Paolasgm/Intro-to-CAD-2026/Intro-to-CAD-2026_floorplan_start.png

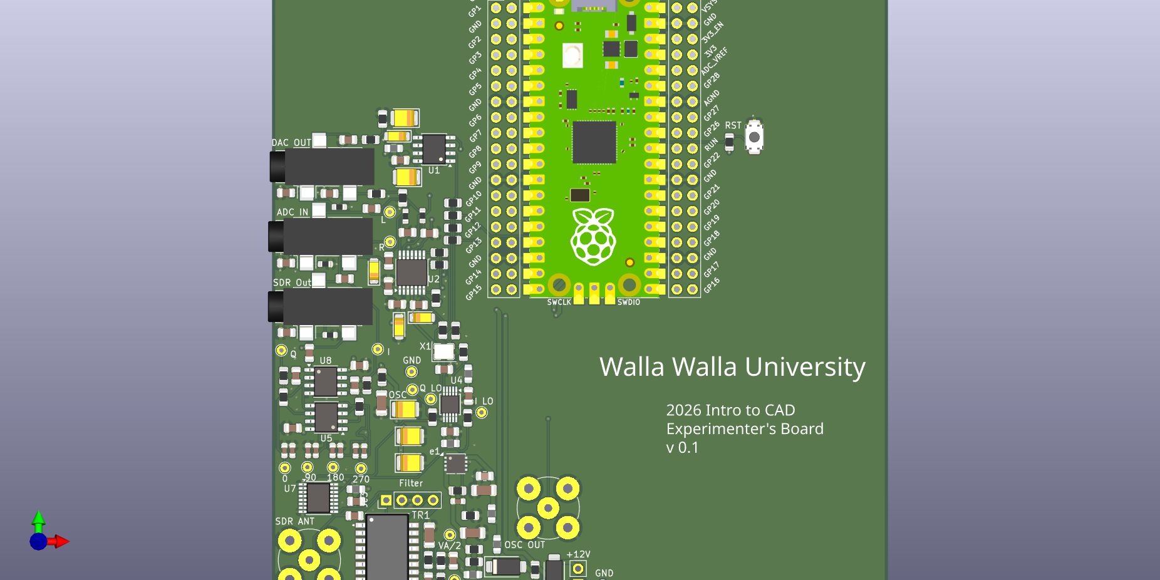
Intro-to-CAD-2026_floorplan_start.png
