Paolasgm/Intro-to-CAD-2026/audio_jack.step

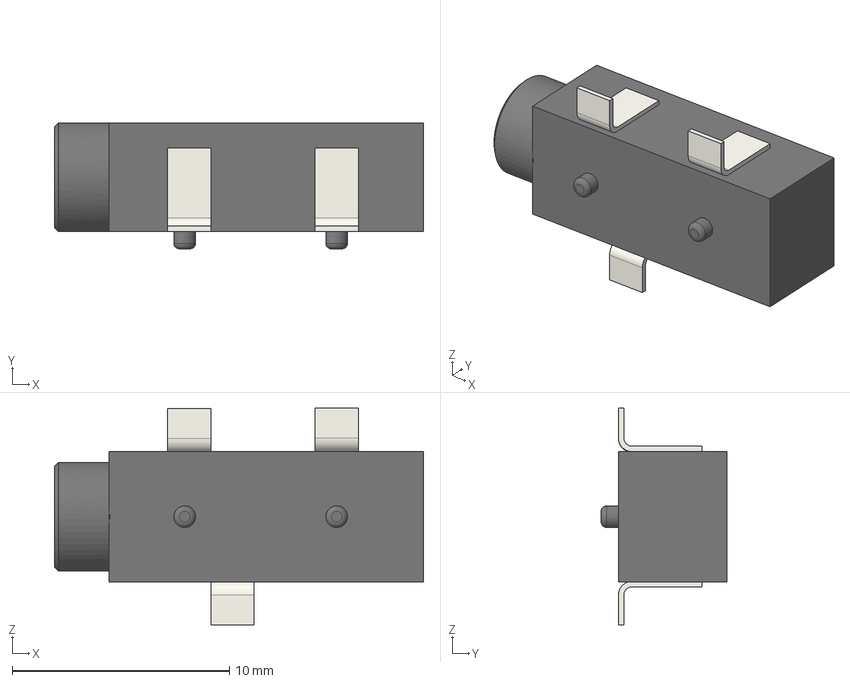
[picture p4: CAD file, 2026-02-01]
audio_jack.step
17.0 x 5.80 x 9.98 mm
sj-3524-smt-tr-pi v1 x 2
BB x 2
sj-3524-smt-tr-pi v003
sj-3524-smt-tr-pi v004 x 2
