Paolasgm/Intro-to-CAD-2026/SJ-3523-sj-3524-smt-tr-pi v005sj-3524-smt-tr-pi v003.step

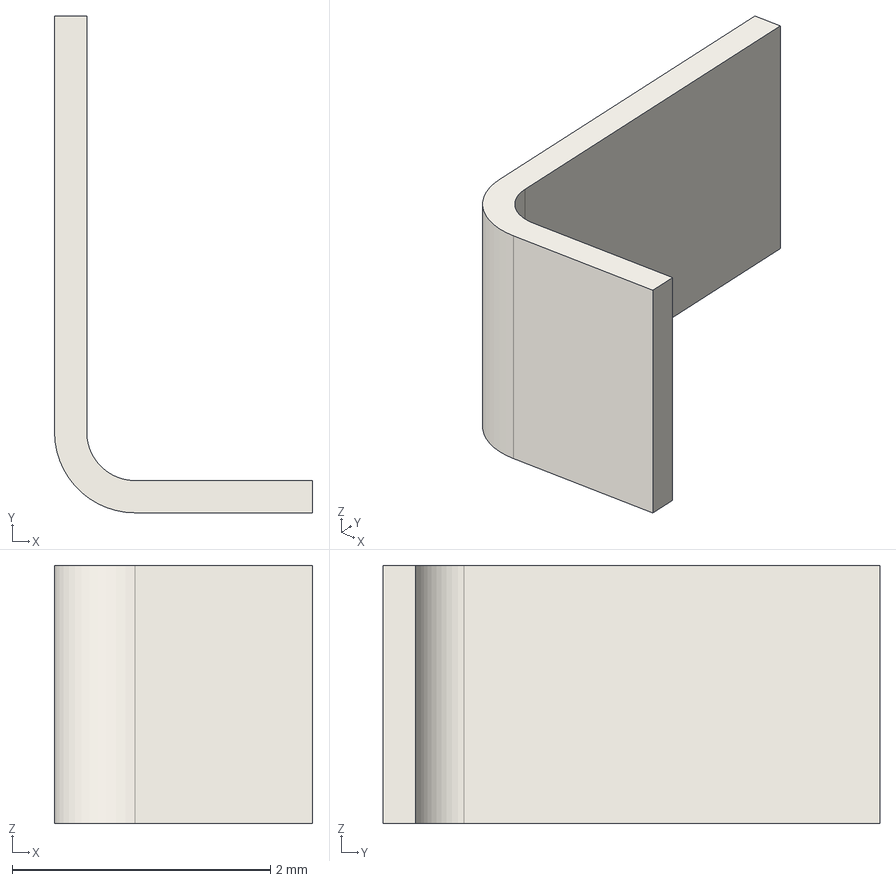
[picture p5: CAD file, 2026-02-01]
SJ-3523-sj-3524-smt-tr-pi v005sj-3524-smt-tr-pi v003.step
2.00 x 3.85 x 2.00 mm
