Paolasgm/Intro-to-CAD-2026/SJ-3523-sj-3524-smt-tr-pi v005.step

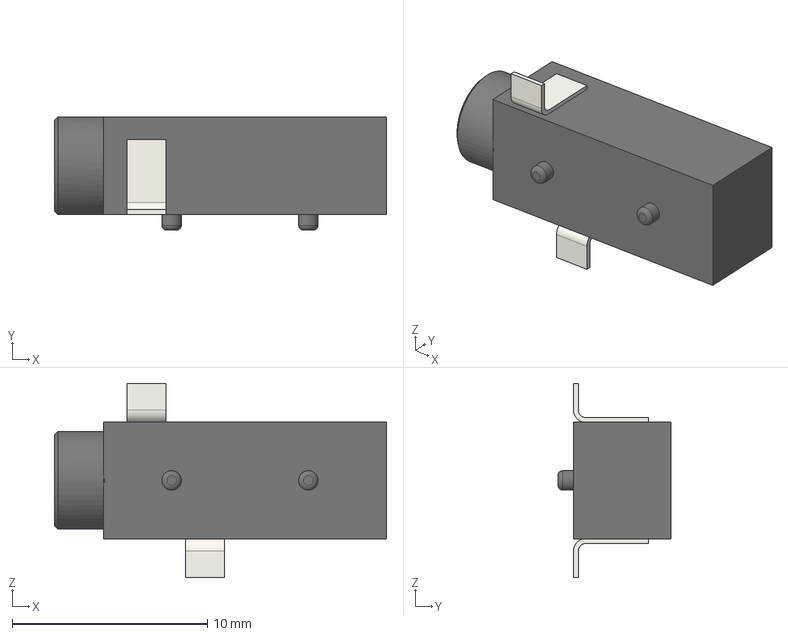
[picture p7: CAD file, 2026-02-01]
SJ-3523-sj-3524-smt-tr-pi v005.step
17.0 x 5.80 x 9.96 mm
sj-3524-smt-tr-pi v1
sj-3524-smt-tr-pi v002
sj-3524-smt-tr-pi v004
