Paolasgm/Intro-to-CAD-2026/PJ-326.step

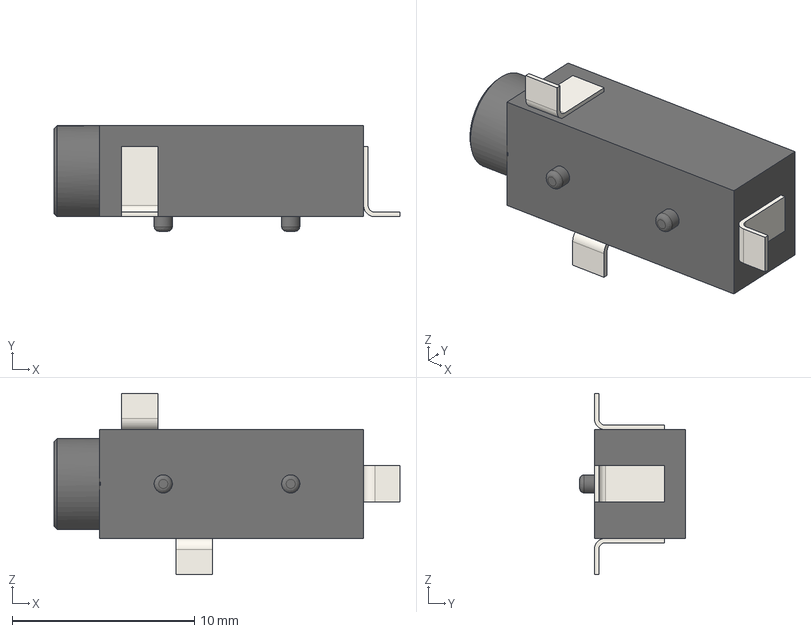
[picture p8: CAD file, 2026-02-01]
PJ-326.step
19.0 x 5.80 x 9.96 mm
