Paolasgm/Intro-to-CAD-2026/Download_STEP_150505M173300_rev1.stp

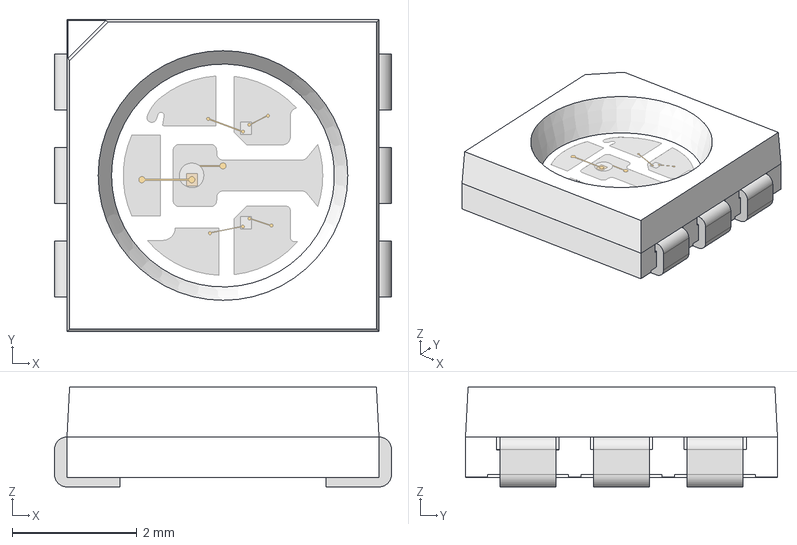
[picture p9: CAD file, 2026-02-01]
Download_STEP_150505M173300_rev1.stp
5.40 x 5.00 x 1.60 mm
cover
housing
base x 2
