Paolasgm/Intro-to-CAD-2026/Amphenol RF 122404.STEP

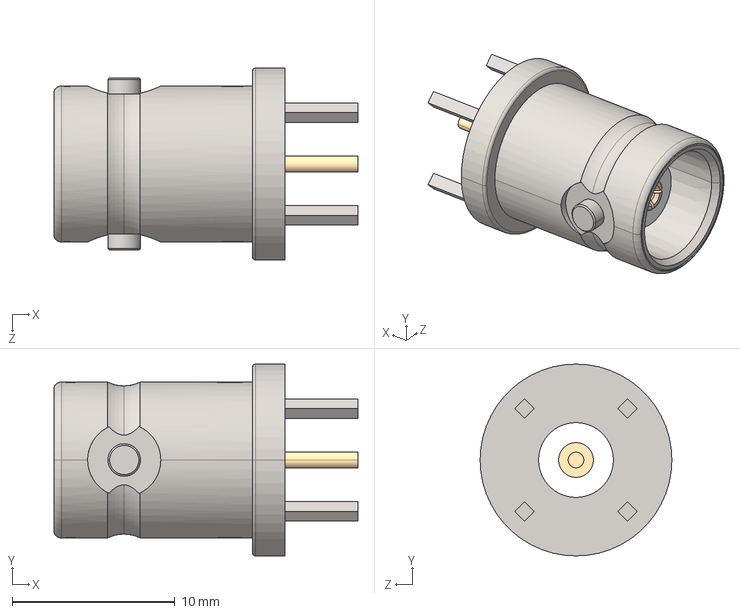
[picture p10: CAD file, 2026-02-01]
Amphenol RF 122404.STEP
18.7 x 11.8 x 11.8 mm
