Paolasgm/Intro-to-CAD-2026/Multiwatt15_V_STM.step

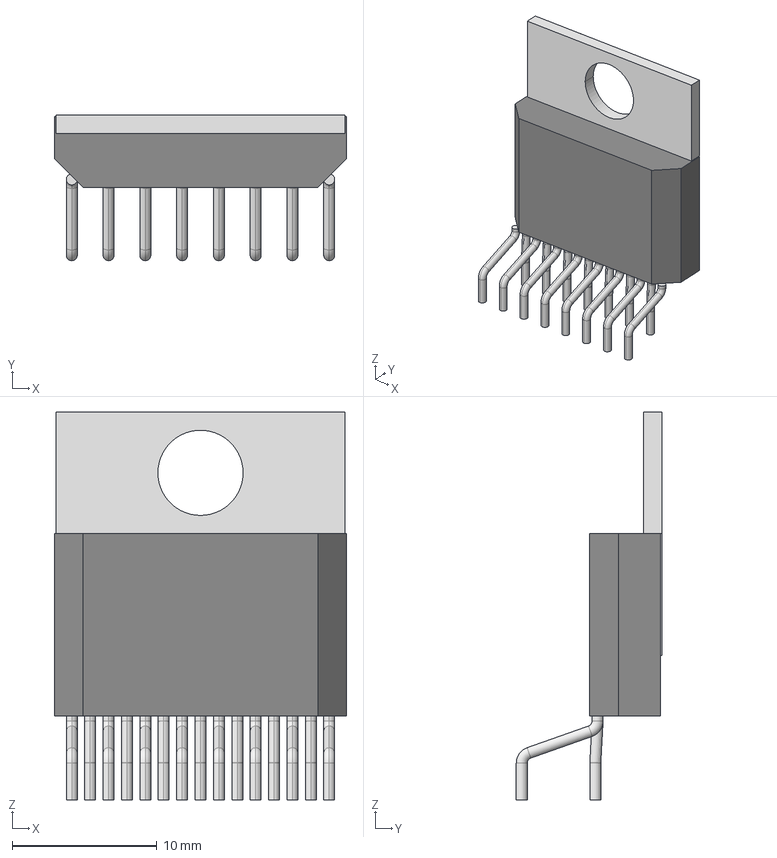
[picture p11: CAD file, 2026-02-01]
Multiwatt15_V_STM.step
20.2 x 10.1 x 26.8 mm
