Paolasgm/Intro-to-CAD-2026/H1102NLT.step

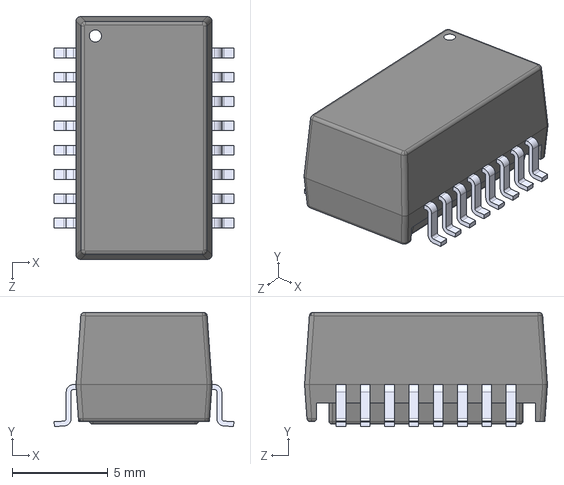
[picture p12: CAD file, 2026-01-30]
H1102NLT.step
9.40 x 5.97 x 12.7 mm
