Paolasgm/Intro-to-CAD-2026/C18594.step

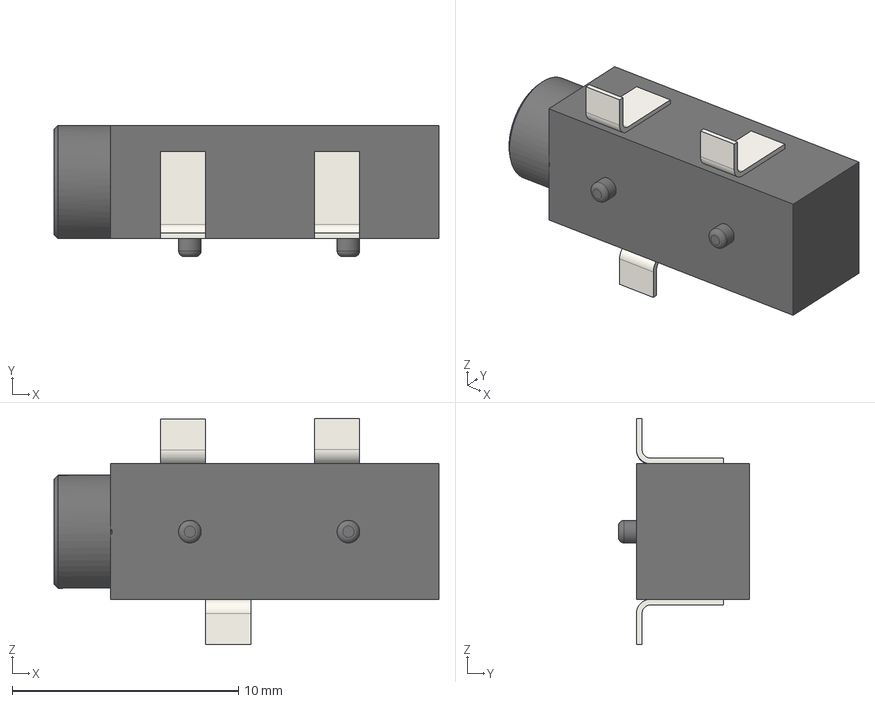
[picture p13: CAD file, 2026-02-01]
C18594.step
17.0 x 5.80 x 9.98 mm
sj-3524-smt-tr-pi v1 x 5
sj-3524-smt-tr-pi v002 x 5
sj-3524-smt-tr-pi v003 x 2
sj-3524-smt-tr-pi v004 x 2
