Paolasgm/Intro-to-CAD-2026/Intro-to-CAD-2026.kicad_pcb

## KiCad design Intro-to-CAD-2026.kicad_pcb (2026-02-07)

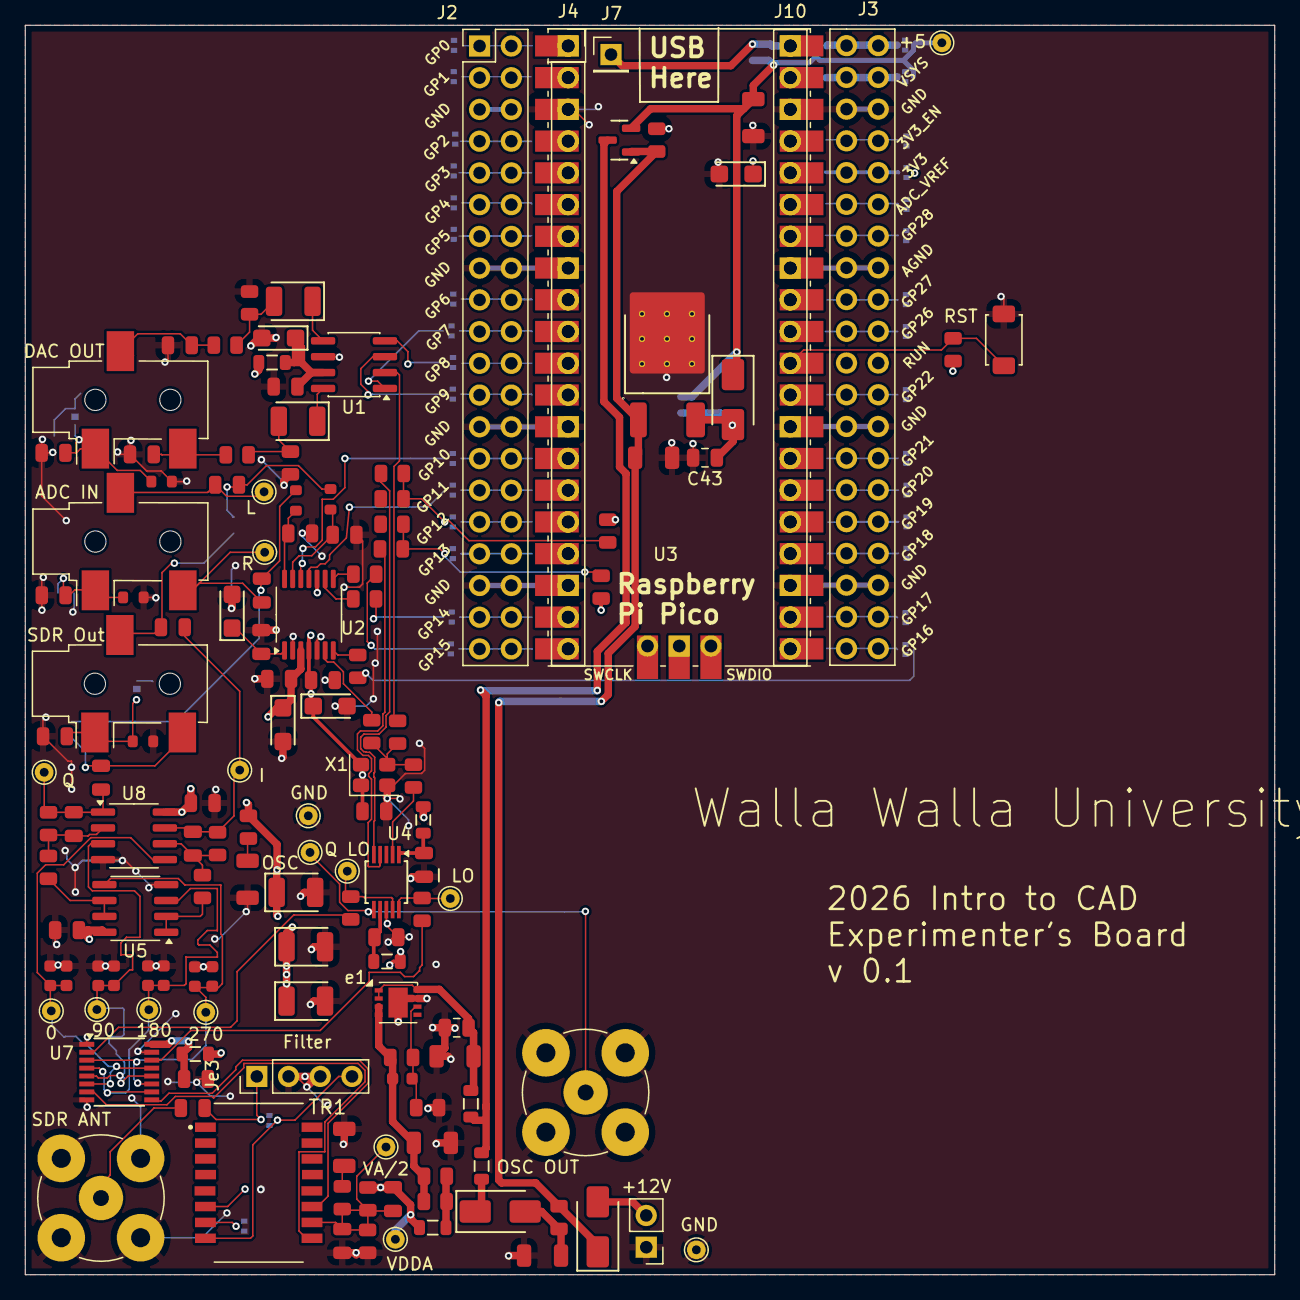
[picture p14: board Intro-to-CAD-2026.kicad_pcb from above]

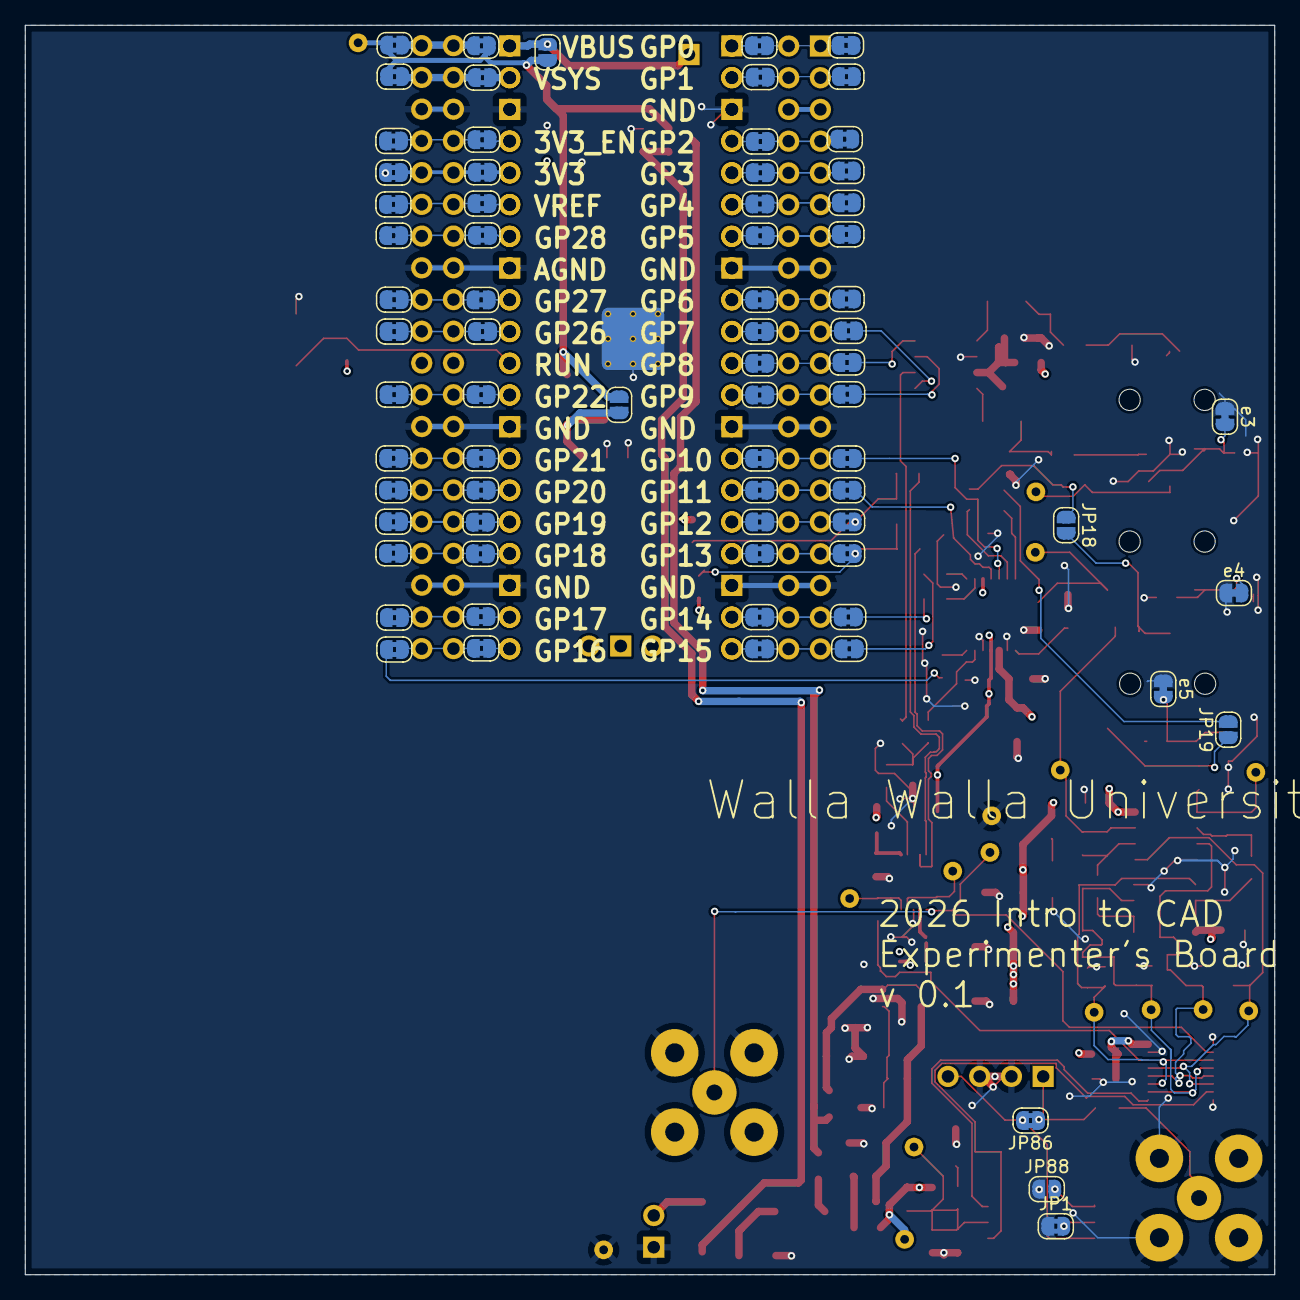
[picture p15: board Intro-to-CAD-2026.kicad_pcb from below]

Board: 4 copper layers, 100.0 x 100.0 mm, 215 parts (72 on the bottom side), 143 nets.

Parts:
C1, C10, C11, C12, C13, C15, C20, C23, C30, C31, C32, C38, C48, C50, C51, C52: 100nF; C_0805
C2, C5, C33, C34, C35, C41, C42: 10uF; C_1206
C3, C4, C21, C29: 1uF; C_0805
C6, C7, C49, C53: 2.2nF; C_0805
C8, C9, C39, C44, C45: 10uF; C_CASE-A-3216-18(mm)
C14, C16, C19, C22, C24, C25, C26, C27: 330pF; C_0603
C17, C36, C37, C46, C47: 100uF; C_CASE-B-3528-21(mm)
C18, C28: 100pF; C_0805
C40: 4.7pF; C_0603
C43, C55: 0.1u; C_0805_2012Metric
D1, D2, D3: SS14; D_SMA
FB1, FB2, FB3, FB4, FB5, FB6, FB7: FB_0805
J1: ADC IN; Jack_3.5mm_CUI_SJ-3523-SMT_Horizontal
J2: Conn_02x20_Counter_Clockwise; PinSocket_2x20_P2.54mm_Vertical_pins1-20
J3: Conn_02x20_Counter_Clockwise; PinSocket_2x20_P2.54mm_Vertical_Counterclockwise_pins21-40
J4: Conn_01x20_Socket; PinSocket_1x20_P2.54mm_Vertical
J5: +12V; PinHeader_1x02_P2.54mm_Vertical
J7: Conn_01x01_Pin; PinHeader_1x01_P2.54mm_Vertical
J8: OSC OUT; BNC_TEConnectivity_1478204_Vertical
J9: DAC OUT; Jack_3.5mm_CUI_SJ-3523-SMT_Horizontal
J10: Conn_01x20_Socket; PinSocket_1x20_P2.54mm_Vertical-pins21-40
J11: SDR ANT; BNC_TEConnectivity_1478204_Vertical
J12: SDR Out; Jack_3.5mm_CUI_SJ-3523-SMT_Horizontal
JP1, JP20, JP21, JP22, JP23, JP24, JP25, JP26, JP27, JP28, JP29, JP30, JP31, JP32, JP33, JP34, JP35, JP36, JP37, JP38, JP39, JP40, JP41, JP42, JP43, JP44, JP45, JP46, JP47, JP48, JP49, JP51, JP52, JP53, JP54, JP55, JP56, JP57, JP58, JP59, JP60, JP61, JP62, JP63, JP64, JP65, JP66, JP67, JP68, JP70, JP71, JP72, JP73, JP74, JP75, JP76, JP77, JP78, JP79, JP80, JP81, JP82, JP83, JP86: Jumper_2_Bridged; SolderJumper-2_P1.3mm_Bridged2Bar_RoundedPad1.0x1.5mm
JP2: SolderJumper-2_P1.3mm_Open_RoundedPad1.0x1.5mm
JP18, JP19, JP88: GND_LP_SND; SolderJumper-2_P1.3mm_Open_RoundedPad1.0x1.5mm
JP50: USB Only; SolderJumper-2_P1.3mm_Open_RoundedPad1.0x1.5mm
Je3: Filter; PinHeader_1x04_P2.54mm_Vertical
Q1: AO3401A; Q_SOT-23
R1, R4, R12, R13, R31, R32: 10kΩ; R_0805
R2, R3: 430Ω; R_0603
R5: 33kΩ; R_0805
R6: 12kΩ; R_0805
R7, R10, R11, R20, R21: 1Ω; R_0805
R8, R9: 47Ω; R_0805
R14, R19, R30: 10Ω; R_0603
R15, R23: 4.7kΩ; R_0805
R16, R17, R18, R34, R35, R36, R37, R38: 33Ω; R_0805
R22, R33: 560Ω; R_0805
R24, R25, R26, R27: 100Ω; R_0805
R28: 100kΩ; R_0805
R29: 20kΩ; R_0805
S1: RST; SW_TS-1088-AR02016
TP1: L; TestPoint_THTPad_D1.5mm_Drill0.7mm
TP2: R; TestPoint_THTPad_D1.5mm_Drill0.7mm
TP3: I LO; TestPoint_THTPad_D1.5mm_Drill0.7mm
TP4: Q LO; TestPoint_THTPad_D1.5mm_Drill0.7mm
TP5: OSC; TestPoint_THTPad_D1.5mm_Drill0.7mm
TP6: 180; TestPoint_THTPad_D1.5mm_Drill0.7mm
TP7: 270; TestPoint_THTPad_D1.5mm_Drill0.7mm
TP10, TP12: GND; TestPoint_THTPad_D1.5mm_Drill0.7mm
TP11: VA/2; TestPoint_THTPad_D1.5mm_Drill0.7mm
TP14: 0; TestPoint_THTPad_D1.5mm_Drill0.7mm
TP16: 90; TestPoint_THTPad_D1.5mm_Drill0.7mm
TP17: I; TestPoint_THTPad_D1.5mm_Drill0.7mm
TP18: Q; TestPoint_THTPad_D1.5mm_Drill0.7mm
TP25: +5; TestPoint_THTPad_D1.5mm_Drill0.7mm
TP26: VDDA; TestPoint_THTPad_D1.5mm_Drill0.7mm
TR1: H1102NLT; XFMR_H1102NLT
U1: CJC4334H; SOIC-8_3.9x4.9mm_P1.27mm
U2: PCM1808PWR; TSSOP-14_4.4x5mm_P0.65mm
U3: Pico; RPi_Pico_SMD_TH
U4: MS5351M; MSOP-10_3x3mm_P0.5mm
U5, U8: OPA1612AxD; SOIC-8_3.9x4.9mm_P1.27mm
U6: L78M05ABDT-TR; TO-252-2_L6.5-W6.1-P4.58-LS10.0-TL
U7: SN74CBT3253; SSOP-16_3.9x4.9mm_P0.635mm
X1: YC24.576MUBCE2O; Oscillator_SMD_Abracon_ASE-4Pin_3.2x2.5mm
e1: SGM2205-ADJXTDB8G/TR; DFN-8-1EP_3x3mm_P0.65mm_EP1.55x2.4mm
e3, e4, e5: Groundloop_Insurance; SolderJumper-2_P1.3mm_Bridged_RoundedPad1.0x1.5mm

Connections:
+3.3V: C8.1, C10.2, C39.1, C48.1, FB1.1, FB4.2, FB7.2, J2.3 (Pin_38), J3.30 (Pin_11), JP23.1 (A), R15.1, R23.1, R29.1, U2.4 (VDD), U2.10 (MD0), X1.1 (EN), X1.4 (Vdd)
+4.7V: C2.1, D3.1, JP2.2 (B), JP20.1 (A), JP21.1 (A), JP35.2 (B), JP50.2 (B), Q1.2 (S), TP25.1
/BCK: JP83.2 (B), R17.2
/CMOS Oscillator/LO_CLK: R36.1, U4.2 (XA)
/CMOS Oscillator/SCKI: R35.2, U2.6 (SCKI)
/CMOS Oscillator/SCLK: R34.1, U1.2 (SCLK)
/DATA: JP82.2 (B), R18.2
/FMT: JP78.2 (B), U2.12 (FMT)
/I: C29.2, J12.R, JP18.2 (B)
/I_CLK: R37.1, U7.14 (S0)
/LRCK: JP77.2 (B), U1.3 (LRCK)
/MCLK: JP76.2 (B), U1.4 (MCLK)
/MD1: JP79.2 (B), U2.11 (MD1)
/OSC_SCL: R25.1, U4.4 (SCL)
/OSC_SDA: R24.1, U4.5 (SDA)
/Q: C21.1, J12.T, JP19.1 (A)
/Q_CLK: R38.1, U7.2 (S1)
/Raspberry_Pi_Pico/GPIO12: JP80.2 (B), R15.2, R24.2, R27.2
/Raspberry_Pi_Pico/GPIO13: JP81.2 (B), R23.2, R25.2, R26.2
/Raspberry_Pi_Pico/RST: J10.30 (Pin_11), R29.2, S1.1 (A), U3.30 (RUN)
/SDIN: JP75.2 (B), U1.1 (SDIN)
/Si5351a/CLK2: J8.1 (In), TP5.1, U4.6 (CLK2)
/WS: JP34.1 (A), R16.2
GND: C2.2, C5.2, C6.2, C7.2, C8.2, C9.2, C10.1, C11.1, C12.2, C13.1, C14.2, C15.1, C16.2, C17.2, C19.2, C20.1, C22.2, C23.1, C24.2, C25.2, C26.2, C27.2, C30.1, C31.1, C33.2, C34.2, C35.2, C36.2, C37.2, C38.1, C39.2, C41.2, C42.2, C43.2, C44.2, C45.2, C48.2, C49.2, C50.1, C51.1, C52.1, C53.2, C55.2, J2.8 (Pin_33), J2.13, J2.18, J3.23 (Pin_18), J3.28, J3.33 (Pin_8), J3.38, J4.3, J4.8, J4.13, J4.18, J5.1, J8.2 (Ext), J10.23 (Pin_18), J10.28 (Pin_13), J10.33 (Pin_8), J10.38 (Pin_3), J11.2 (Ext), JP1.1 (A), JP88.1 (A), Je3.2, Je3.3, R4.1, R6.2, R14.2, R19.2, R28.2, R30.2, R31.2, R32.2, S1.2 (B), TP10.1, TP12.1, U1.6 (GND), U2.2 (AGND), U2.5 (DGND), U3.3 (GND), U3.8 (GND), U3.13 (GND), U3.18 (GND), U3.23 (GND), U3.28 (GND), U3.33 (AGND), U3.38 (GND), U4.8 (GND), U5.4 (V-), U6.4 (GND), U7.1 (1~OE), U7.8 (GND), U7.15 (2~OE), U8.4 (V-), X1.2 (GND), e1.7 (GND), e1.9 (PAD), e3.1 (A), e4.1 (A), e5.1 (A)
unnamed: C3.2, J1.R, TP1.1
unnamed: C4.2, J1.T, TP2.1
unnamed: C18.2, C29.1, R12.2, TP17.1, U8.7
unnamed: C21.2, C28.2, R13.2, TP18.1, U8.1
unnamed: C33.1, R11.2
unnamed: C34.1, R10.2
unnamed: C35.1, C40.1, R5.2, R7.1, R20.1, e1.3 (VOUT), e1.4 (VOUT)
unnamed: C42.1, D1.2, R21.1
unnamed: C46.2, R22.1, R32.1
unnamed: C47.2, R31.1, R33.1
unnamed: C49.1, J9.R, R22.2
unnamed: C53.1, J9.T, R33.2
unnamed: D1.1, FB2.2
unnamed: FB5.1, R7.2, R20.2
unnamed: J2.1, JP51.2 (B), JP67.1 (A)
unnamed: J2.2, JP52.2 (B), JP68.1 (A)
unnamed: J2.10, JP58.2 (B), JP75.1 (A)
unnamed: J2.11, JP59.2 (B), JP76.1 (A)
unnamed: J2.12, JP60.2 (B), JP77.1 (A)
unnamed: J2.14, JP61.2 (B), JP78.1 (A)
unnamed: J2.15, JP62.2 (B), JP79.1 (A)
unnamed: J2.16, JP63.2 (B), JP80.1 (A)
unnamed: J2.17, JP64.2 (B), JP81.1 (A)
unnamed: J2.19, JP65.2 (B), JP82.1 (A)
unnamed: J2.20, JP66.2 (B), JP83.1 (A)
unnamed: J2.9, JP57.2 (B), JP74.1 (A)
unnamed: J2.7, JP56.2 (B), JP73.1 (A)
unnamed: J2.6, JP55.2 (B), JP72.1 (A)
unnamed: J2.5, JP54.2 (B), JP71.1 (A)
unnamed: J2.4, JP53.2 (B), JP70.1 (A)
unnamed: J3.40 (Pin_1), JP20.2 (B), JP35.1 (A)
unnamed: J3.39 (Pin_2), JP21.2 (B), JP36.1 (A)
unnamed: J3.31 (Pin_10), JP27.2 (B), JP42.1 (A)
unnamed: J3.29 (Pin_12), JP28.2 (B), JP43.1 (A)
unnamed: J3.27 (Pin_14), JP29.2 (B), JP44.1 (A)
unnamed: J3.26 (Pin_15), JP30.2 (B), JP45.1 (A)
unnamed: J3.25 (Pin_16), JP31.2 (B), JP46.1 (A)
unnamed: J3.24 (Pin_17), JP32.2 (B), JP47.1 (A)
unnamed: J3.22 (Pin_19), JP33.2 (B), JP48.1 (A)
unnamed: J3.21 (Pin_20), JP34.2 (B), JP49.1 (A)
unnamed: J3.32 (Pin_9), JP26.2 (B), JP41.1 (A)
unnamed: J3.34 (Pin_7), JP25.2 (B), JP40.1 (A)
unnamed: J3.35 (Pin_6), JP24.2 (B), JP39.1 (A)
unnamed: J3.36 (Pin_5), JP23.2 (B), JP38.1 (A)
unnamed: J3.37 (Pin_4), JP22.2 (B), JP37.1 (A)
unnamed: J4.1, JP51.1 (A), U3.1 (GPIO0)
unnamed: J4.2, JP52.1 (A), U3.2 (GPIO1)
unnamed: J4.4, JP53.1 (A), U3.4 (GPIO2)
unnamed: J4.5, JP54.1 (A), U3.5 (GPIO3)
unnamed: J4.6, JP55.1 (A), U3.6 (GPIO4)
unnamed: J4.7, JP56.1 (A), U3.7 (GPIO5)
unnamed: J4.9, JP57.1 (A), U3.9 (GPIO6)
unnamed: J4.10, JP58.1 (A), U3.10 (GPIO7)
unnamed: J4.11, JP59.1 (A), U3.11 (GPIO8)
unnamed: J4.12, JP60.1 (A), U3.12 (GPIO9)
unnamed: J4.14, JP61.1 (A), U3.14 (GPIO10)
unnamed: J4.15, JP62.1 (A), U3.15 (GPIO11)
unnamed: J4.16, JP63.1 (A), U3.16 (GPIO12)
unnamed: J4.17, JP64.1 (A), U3.17 (GPIO13)
unnamed: J4.19, JP65.1 (A), U3.19 (GPIO14)
unnamed: J4.20, JP66.1 (A), U3.20 (GPIO15)
unnamed: D2.2, J5.2
unnamed: J7.1, J10.40 (Pin_1), JP50.1 (A), U3.40 (VBUS)
unnamed: J10.39 (Pin_2), JP36.2 (B), U3.39 (VSYS)
unnamed: J10.37 (Pin_4), JP37.2 (B), U3.37 (3V3_EN)
unnamed: J10.36 (Pin_5), JP38.2 (B), U3.36 (3V3)
unnamed: J10.35 (Pin_6), JP39.2 (B), U3.35 (ADC_VREF)
unnamed: J10.34 (Pin_7), JP40.2 (B), U3.34 (GPIO28_ADC2)
unnamed: J10.32 (Pin_9), JP41.2 (B), U3.32 (GPIO27_ADC1)
unnamed: J10.31 (Pin_10), JP42.2 (B), U3.31 (GPIO26_ADC0)
unnamed: J10.29 (Pin_12), JP43.2 (B), U3.29 (GPIO22)
unnamed: J10.27 (Pin_14), JP44.2 (B), U3.27 (GPIO21)
unnamed: J10.26 (Pin_15), JP45.2 (B), U3.26 (GPIO20)
unnamed: J10.25 (Pin_16), JP46.2 (B), U3.25 (GPIO19)
unnamed: J10.24 (Pin_17), JP47.2 (B), U3.24 (GPIO18)
unnamed: J10.22 (Pin_19), JP48.2 (B), U3.22 (GPIO17)
unnamed: J10.21 (Pin_20), JP49.2 (B), U3.21 (GPIO16)
unnamed: C1.1, J11.1 (In)
unnamed: JP1.2 (B), TR1.7 (C_RD)
unnamed: C43.1, D3.2, JP2.1 (A), U6.3 (VOUT)
unnamed: C3.1, JP18.1 (A), R2.1
unnamed: C4.1, JP19.2 (B), R3.1
unnamed: C1.2, JP86.1 (A), Je3.1
unnamed: JP86.2 (B), Je3.4, TR1.8 (RD-)
unnamed: JP88.2 (B), TR1.6 (RD+)
unnamed: FB2.1, FB6.1, Q1.3 (D)
unnamed: C41.1, D2.1, Q1.1 (G), R21.2, R28.1, U6.1 (VIN)
unnamed: C20.2, C32.2, R1.1, R4.2, R10.1, TP11.1, TR1.10 (C_RX)
unnamed: TR1.11 (RX+), U7.9 (2A)
unnamed: TR1.9 (RX-), U7.7 (1A)
unnamed: C47.1, U1.8 (AOUTL)
unnamed: C46.1, U1.5 (AOUTR)
unnamed: C12.1, C45.1, FB7.1, U1.7 (VDD)
unnamed: R17.1, U2.8 (BCK)
unnamed: R18.1, U2.9 (DOUT)
unnamed: R16.1, U2.7 (LRCK)
unnamed: C6.1, R2.2, U2.13 (VINL)
unnamed: C7.1, R3.2, U2.14 (VINR)
unnamed: C11.2, C44.1, U2.1 (VREF)
unnamed: R37.2, TP3.1, U4.10 (CLK0)
unnamed: R38.2, TP4.1, U4.9 (CLK1)
unnamed: C15.2, FB4.1, U4.1 (VDD)
unnamed: C38.2, FB1.2, U4.7 (VDDO)
unnamed: C22.1, C26.1, TP6.1, U5.3 (+), U7.4 (1B3), U7.10 (2B1)
unnamed: R8.1, U5.1, U5.2 (-)
unnamed: C24.1, C27.1, TP7.1, U5.5 (+), U7.3 (1B4), U7.11 (2B2)
unnamed: R9.1, U5.6 (-), U5.7
unnamed: C14.1, C16.1, TP14.1, U7.6 (1B1), U7.13 (2B4), U8.5 (+)
unnamed: C19.1, C25.1, TP16.1, U7.5 (1B2), U7.12 (2B3), U8.3 (+)
unnamed: C23.2, FB3.1, U7.16 (VCC)
unnamed: C28.1, R9.2, R13.1, U8.2 (-)
unnamed: C18.1, R8.2, R12.1, U8.6 (-)
unnamed: R34.2, R35.1, R36.2, X1.3 (OUT)
unnamed: C5.1, C55.1, FB6.2, e1.1 (VIN), e1.2 (VIN), e1.8 (EN)
unnamed: C40.2, R5.1, R6.1, e1.6 (SENSE/ADJ)
unnamed: C50.2, J9.S, R19.1, e3.2 (B)
unnamed: C51.2, J1.S, R14.1, e4.2 (B)
unnamed: C52.2, J12.S, R30.1, e5.2 (B)
VDDA: C9.1, C13.2, C17.1, C30.2, C31.2, C32.1, C36.1, C37.1, FB3.2, FB5.2, R1.2, R11.1, TP26.1, U2.3 (VCC), U5.8 (V+), U8.8 (V+)
