Paolasgm/Intro-to-CAD-2026/(commit log)

2026-01-30 Added a Module Template
    [Intro-to-CAD-2026.kicad_sch, Module_Template.kicad_pcb, Module_Template.kicad_sch, raspberry_pi_pico.kicad_sch]
2026-01-30 Making module instructions...
    [PCM1808_Sound_In.kicad_sch]
2026-01-30 Moved my development to Frohne
    [Frohne.kicad_pcb, Frohne.kicad_sch, Module_Template.kicad_sch, VDDA.kicad_sch, pcm1808.kicad_sch, qsd-sdr.kicad_sch, raspberry_pi_pico.kicad_sch, si5351a.kicad_sch]
2026-01-31 Fixed the rest of the schematic errors
    [Module_Template.kicad_sch]
2026-02-01 Fixed a number of things
    [Amphenol RF 122404.STEP, C18594.step, Download_STEP_150505M173300_rev1.stp, Frohne.kicad_pcb, Multiwatt15_V_STM.step, PJ-326.step, SJ-3523-sj-3524-smt-tr-pi v005.step, SJ-3523-sj-3524-smt-tr-pi v005sj-3524-smt-tr-pi v003.step]
2026-02-01 Added DAC
    [Frohne.kicad_pcb, Frohne.kicad_sch, VDDA.kicad_sch, cmos_oscillator.kicad_sch, dac.kicad_sch, pcm1808.kicad_sch, qsd-sdr.kicad_sch, raspberry_pi_pico.kicad_sch]
2026-02-02 Tuned length of I and Q.
    [Frohne.kicad_pcb, Frohne.kicad_sch, si5351a.kicad_sch]
2026-02-02 Made length of sampling caps the same.
    [Frohne.kicad_pcb]
2026-02-03 40 unconnected
    [Frohne.kicad_pcb, VDDA.kicad_sch]
2026-02-03 forgot to save
    [Frohne.kicad_pcb]
2026-02-04 410 warnings
    [Frohne.kicad_pcb]
2026-02-10 Removed accidentally added MicroSD-breakout-board/.
    [microsd.brd, microsd.sch]
2026-02-11 Fixed reference to the pico subsheet
    [Intro-to-CAD-2026.kicad_sch]
2026-02-11 Fixed reference in root schematic to pico.
    [raspberry_pi_pico.kicad_sch]
2026-02-11 Moved my .kicad_pcb to the main directory.
    [Intro-to-CAD-2026.kicad_pcb]
2026-02-12 Added DAC Amp for Paula and Shaina.
    [VDDA.kicad_sch, dac.kicad_sch]
2026-02-12 Some insurance added to the DAC Amp
    [VDDA.kicad_sch, dac.kicad_sch, microsd.brd, microsd.sch]
2026-02-12 Fixed VA/2
    [dac.kicad_sch]
2026-02-12 Changes from simulations.
    [dac.kicad_sch]
2026-02-12 Forgot the other channel.
    [dac.kicad_sch]
2026-02-13 Updated simulations.
    [qsd-sdr.kicad_sch]
2026-02-18 Create Intro-to-CAD-2026 latest.kicad_pcb
