Paolasgm/Intro-to-CAD-2026/(notices)

Notices in the files:
MicroSD-breakout-board/microsd.brd:
CC BY-SA
